odevsa/arduino-gt3-steering-wheel/arduino-gt3-steering-wheel.ino

#include <Arduino.h>
#include <BleGamepad.h>
#include "driver/rtc_io.h"
#include "esp32-hal-cpu.h"

// #define DEBUG

// CPU Frequency and Sleep Timeout
#define CPU_FREQ_MHZ 80
#define SLEEP_TIMEOUT_MS 300000 // 1000 * 60 * 5 = 5 minutes

unsigned long lastActivityTime = 0;

// Buttons Matrix
#define PIN_BUTTON_ARRAY_ROW (int[4]){32, 33, 25, 26}
#define PIN_BUTTON_ARRAY_COL (int[3]){14, 12, 13}

int buttonRowSize =
    sizeof(PIN_BUTTON_ARRAY_ROW) / sizeof(PIN_BUTTON_ARRAY_ROW[0]);
int buttonColSize =
    sizeof(PIN_BUTTON_ARRAY_COL) / sizeof(PIN_BUTTON_ARRAY_COL[0]);

// Encoders
#define PIN_LEFT_ENCODER_DATA 19
#define PIN_LEFT_ENCODER_CLOCK 18
#define PIN_LEFT_ENCODER_SWITCH 21
#define PIN_RIGHT_ENCODER_DATA 16
#define PIN_RIGHT_ENCODER_CLOCK 17
#define PIN_RIGHT_ENCODER_SWITCH 4
#define ENCODER_DEBOUNCE 500

volatile int leftEncoderDelta = 0;
volatile int rightEncoderDelta = 0;
volatile uint8_t prevLeftState = 0;
volatile uint8_t prevRightState = 0;
volatile uint32_t lastLeftEncMicros = 0;
volatile uint32_t lastRightEncMicros = 0;

// Battery
#define PIN_BATTERY_LEVEL 34
#define BATTERY_VOLTAGE_MAX 4.2f
#define BATTERY_VOLTAGE_MIN 3.0f
#define BATTERY_ADC_REFERENCE 3.575f
#define BATTERY_ADC_MAX 4095.0f
#define BATTERY_DIVIDER_RATIO ((100.0f + 100.0f) / 100.0f) // 2 resistors of 100k ohms
#define BATTERY_AVG_AMOUNT 10
#define BATTERY_READ_INTERVAL 1000
#define BATTERY_READ_PERCENT_DEVIATION_MAX 5

unsigned long lastBatteryRead = 0;
float lastBatteryPercent = 0.0f;
float batteryPercents[BATTERY_AVG_AMOUNT];
bool batteryFirstReport = true;

// Gamepad
#define NUMBER_OF_BUTTONS 18

byte physicalButtons[NUMBER_OF_BUTTONS] = {1, 2, 3, 4, 5, 6, 7, 8, 9,
                                           10, 11, 12, 13, 14, 15, 16, 17, 18};
bool statusChanged = false;

BleGamepad bleGamepad("GT3 Steering Wheel", "odevsa", 100);

void resetActivityTimer() { lastActivityTime = millis(); }

void setButton(int buttonIndex, bool pressed)
{
  if (!pressed)
  {
    bleGamepad.release(physicalButtons[buttonIndex]);
    statusChanged = true;
    return;
  }

  resetActivityTimer();
  bleGamepad.press(physicalButtons[buttonIndex]);
  statusChanged = true;
}

void IRAM_ATTR handleEncoderISR(uint8_t clkPin, uint8_t dtPin, volatile int *delta,
                                volatile uint8_t *prevState, volatile uint32_t *lastMicros)
{
  uint8_t clk = digitalRead(clkPin);
  uint8_t dt = digitalRead(dtPin);
  uint8_t s = (clk << 1) | dt;

  uint32_t t = micros();
  if ((uint32_t)(t - *lastMicros) < ENCODER_DEBOUNCE)
  {
    *prevState = s;
    return;
  }
  *lastMicros = t;

  uint8_t ps = *prevState;
  if (s == ps)
    return;

  uint8_t prev_clk = (ps >> 1) & 1;
  if (prev_clk == 0 && clk == 1)
    dt == 1 ? (*delta)++ : (*delta)--;

  *prevState = s;
}

void IRAM_ATTR leftEncoderISR()
{
  handleEncoderISR(PIN_LEFT_ENCODER_CLOCK, PIN_LEFT_ENCODER_DATA, &leftEncoderDelta, &prevLeftState, &lastLeftEncMicros);
}

void IRAM_ATTR rightEncoderISR()
{
  handleEncoderISR(PIN_RIGHT_ENCODER_CLOCK, PIN_RIGHT_ENCODER_DATA, &rightEncoderDelta, &prevRightState, &lastRightEncMicros);
}

void loadButtons()
{
  int buttonCurrentIndex = 0;

  for (int row = 0; row < buttonRowSize; row++)
  {
    digitalWrite(PIN_BUTTON_ARRAY_ROW[row], LOW);

    for (int col = 0; col < buttonColSize; col++)
      setButton(buttonCurrentIndex++,
                digitalRead(PIN_BUTTON_ARRAY_COL[col]) == LOW);

    digitalWrite(PIN_BUTTON_ARRAY_ROW[row], HIGH);
  }

  setButton(buttonCurrentIndex++, false);
  setButton(buttonCurrentIndex++, false);
  setButton(buttonCurrentIndex++, digitalRead(PIN_LEFT_ENCODER_SWITCH) == LOW);

  setButton(buttonCurrentIndex++, false);
  setButton(buttonCurrentIndex++, false);
  setButton(buttonCurrentIndex++, digitalRead(PIN_RIGHT_ENCODER_SWITCH) == LOW);
}

void pulseButton(int buttonIndex)
{
  resetActivityTimer();

  if (!bleGamepad.isConnected())
  {
    bleGamepad.release(physicalButtons[buttonIndex]);
    statusChanged = true;
  }

  bleGamepad.press(physicalButtons[buttonIndex]);
  bleGamepad.sendReport();
  delay(50);
  bleGamepad.release(physicalButtons[buttonIndex]);
  bleGamepad.sendReport();
  statusChanged = false;
}

void processEncoderDeltas()
{
  noInterrupts();
  int l = leftEncoderDelta;
  int r = rightEncoderDelta;
  leftEncoderDelta = 0;
  rightEncoderDelta = 0;
  interrupts();

  int base = buttonRowSize * buttonColSize;
  if (l < 0)
    pulseButton(base + 0);
  if (l > 0)
    pulseButton(base + 1);
  if (r < 0)
    pulseButton(base + 3);
  if (r > 0)
    pulseButton(base + 4);
}

float loadAverageBatteryPercent()
{
  if (batteryFirstReport)
  {
    for (int i = 0; i < BATTERY_AVG_AMOUNT; i++)
    {
      float percent = loadBatteryPercent();
      delayMicroseconds(100);
      batteryPercents[i] = percent;
    }

    lastBatteryPercent = batteryPercents[BATTERY_AVG_AMOUNT - 1];
    batteryFirstReport = false;
  }

  float percent = loadBatteryPercent();
  float sum = 0.0f;

  if (abs(percent - lastBatteryPercent) < BATTERY_READ_PERCENT_DEVIATION_MAX)
  {
    for (int i = 1; i < BATTERY_AVG_AMOUNT; i++)
      batteryPercents[i - 1] = batteryPercents[i];

    batteryPercents[BATTERY_AVG_AMOUNT - 1] = percent;
  }

  lastBatteryPercent = percent;

  for (int i = 0; i < BATTERY_AVG_AMOUNT; i++)
    sum += batteryPercents[i];

  return sum / BATTERY_AVG_AMOUNT;
}

float loadBatteryPercent()
{
  int adcValue = analogRead(PIN_BATTERY_LEVEL);

  float batteryVoltage = (adcValue / BATTERY_ADC_MAX) * BATTERY_ADC_REFERENCE * BATTERY_DIVIDER_RATIO;
  float percent = (batteryVoltage - BATTERY_VOLTAGE_MIN) / (BATTERY_VOLTAGE_MAX - BATTERY_VOLTAGE_MIN) * 100.0f;

#ifdef DEBUG
  Serial.println("Calculated Voltage: " + String(batteryVoltage, 3));
#endif

  if (percent > 100.0f)
    percent = 100.0f;
  if (percent < 0.0f)
    percent = 0.0f;

  lastBatteryRead = millis();

  return percent;
}

void loadBatteryLevel()
{
  if (millis() - lastActivityTime > SLEEP_TIMEOUT_MS)
    enterDeepSleep();
  if (millis() - lastBatteryRead < BATTERY_READ_INTERVAL)
    return;

  float percent = loadAverageBatteryPercent();

  bleGamepad.setBatteryLevel((int)percent);
  statusChanged = true;

  if (percent <= 0.0f)
  {
    bleGamepad.sendReport();
    delay(500);
    enterDeepSleep();
  }
}

void sendReport()
{
  if (!statusChanged || !bleGamepad.isConnected())
    return;

  bleGamepad.sendReport();
  statusChanged = false;
}

void enterDeepSleep()
{
  for (int i = 0; i < buttonRowSize; i++)
  {
    pinMode(PIN_BUTTON_ARRAY_ROW[i], OUTPUT);
    digitalWrite(PIN_BUTTON_ARRAY_ROW[i], HIGH);
    gpio_hold_en((gpio_num_t)PIN_BUTTON_ARRAY_ROW[i]);
  }

  uint64_t gpio_mask = 0;
  for (int i = 0; i < buttonColSize; i++)
  {
    int pin = PIN_BUTTON_ARRAY_COL[i];

    gpio_mask |= (1ULL << pin);
    rtc_gpio_pulldown_en((gpio_num_t)pin);
    rtc_gpio_pullup_dis((gpio_num_t)pin);
  }

  esp_sleep_enable_ext1_wakeup(gpio_mask, ESP_EXT1_WAKEUP_ANY_HIGH);
  esp_deep_sleep_start();
}

void setup()
{
#ifdef DEBUG
  Serial.begin(115200);
#endif

  // Set CPU Frequency
  setCpuFrequencyMhz(CPU_FREQ_MHZ);

  // Disable GPIO hold if woke up from deep sleep
  if (esp_sleep_get_wakeup_cause() != ESP_SLEEP_WAKEUP_UNDEFINED)
    for (int i = 0; i < buttonRowSize; i++)
      gpio_hold_dis((gpio_num_t)PIN_BUTTON_ARRAY_ROW[i]);

  // Setup Rows of Buttons Matrix
  for (int i = 0; i < buttonRowSize; i++)
    pinMode(PIN_BUTTON_ARRAY_ROW[i], OUTPUT),
        digitalWrite(PIN_BUTTON_ARRAY_ROW[i], HIGH);

  // Setup Columns of Buttons Matrix
  for (int i = 0; i < buttonColSize; i++)
    pinMode(PIN_BUTTON_ARRAY_COL[i], INPUT_PULLUP);

  // Setup Encoders
  pinMode(PIN_LEFT_ENCODER_DATA, INPUT_PULLUP);
  pinMode(PIN_LEFT_ENCODER_CLOCK, INPUT_PULLUP);
  pinMode(PIN_LEFT_ENCODER_SWITCH, INPUT_PULLUP);

  pinMode(PIN_RIGHT_ENCODER_DATA, INPUT_PULLUP);
  pinMode(PIN_RIGHT_ENCODER_CLOCK, INPUT_PULLUP);
  pinMode(PIN_RIGHT_ENCODER_SWITCH, INPUT_PULLUP);

  prevLeftState = (digitalRead(PIN_LEFT_ENCODER_CLOCK) << 1) | digitalRead(PIN_LEFT_ENCODER_DATA);
  prevRightState = (digitalRead(PIN_RIGHT_ENCODER_CLOCK) << 1) | digitalRead(PIN_RIGHT_ENCODER_DATA);
  lastLeftEncMicros = micros();
  lastRightEncMicros = micros();

  attachInterrupt(digitalPinToInterrupt(PIN_LEFT_ENCODER_CLOCK), leftEncoderISR, CHANGE);
  attachInterrupt(digitalPinToInterrupt(PIN_LEFT_ENCODER_DATA), leftEncoderISR, CHANGE);
  attachInterrupt(digitalPinToInterrupt(PIN_RIGHT_ENCODER_CLOCK), rightEncoderISR, CHANGE);
  attachInterrupt(digitalPinToInterrupt(PIN_RIGHT_ENCODER_DATA), rightEncoderISR, CHANGE);

  // Setup Battery Level Pin
  pinMode(PIN_BATTERY_LEVEL, INPUT);

  // Setup BLE Gamepad
  BleGamepadConfiguration bleGamepadConfig;
  bleGamepadConfig.setAutoReport(false);
  bleGamepadConfig.setButtonCount(NUMBER_OF_BUTTONS);
  bleGamepad.begin(&bleGamepadConfig);

  resetActivityTimer();
}

void loop()
{
  loadButtons();
  processEncoderDeltas();
  loadBatteryLevel();
  sendReport();

  delay(10);
}
