odevsa/arduino-gt3-steering-wheel/(commit log)

2025-07-16 Added battery level
2025-11-08 Added wiring diagram
2025-11-28 Several firmware improvements for stability and battery economy
    [arduino-gt3-steering-wheel.ino]
2025-11-28 Added magnets to readme
2025-12-21 Fix encoder reading logic to ensure accurate direction detection
    [arduino-gt3-steering-wheel.ino]
2025-12-21 Enhance encoder handling with improved ISR logic and delta processing
2025-12-21 Refactor encoder ISR functions for improved code reuse and clarity
2025-12-21 Reduce sleep timeout to increase battery holding time
2025-12-22 Fixing wrong battery percentage in deviation filter
    [arduino-gt3-steering-wheel.ino]
